adaptyvbio/open-nest/TRADEMARKS.md

# Trademarks

The licenses in this repository cover the design, not the Adaptyv name or logo. Those stay with
Adaptyv.

You may make, use and sell plates from this design under its license. You may keep the engraving
on a plate built from the unmodified reference geometry, with `cad/nest.py` and your own holes.

If you change the pocket, tabs, notches or seat, build with `--no-branding`, so that the part does
not carry a name that vouches for a design it no longer matches. Do not use the Adaptyv name or
logo to suggest that Adaptyv makes, tests or endorses your plate.

"SLAS" refers to the ANSI SLAS microplate standards. Other product names belong to their owners. This project is not affiliated with any instrument maker.
