adaptyvbio/open-nest/design/identity-board.png

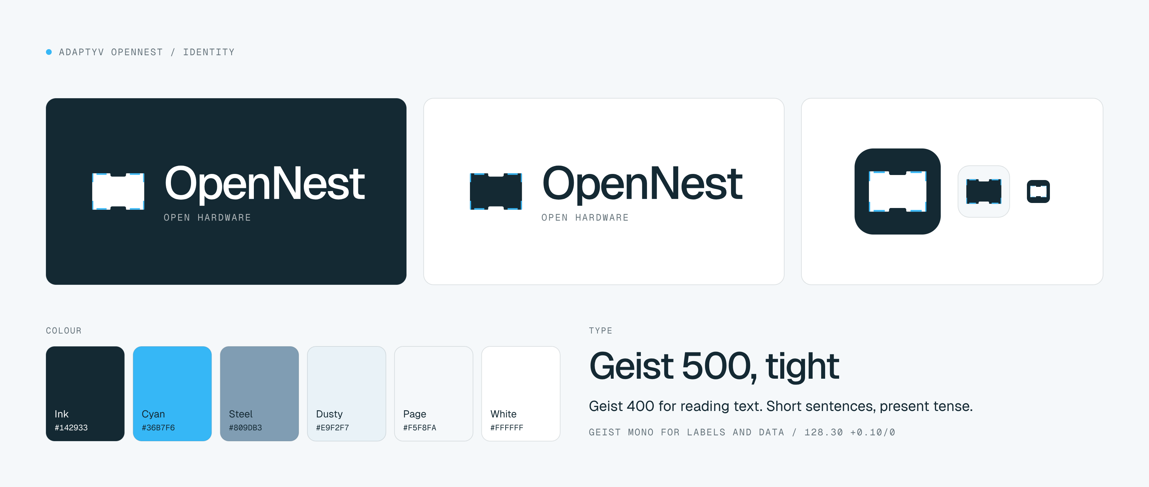
design/identity-board.png
