adaptyvbio/open-nest/docs/img/tab-section.png

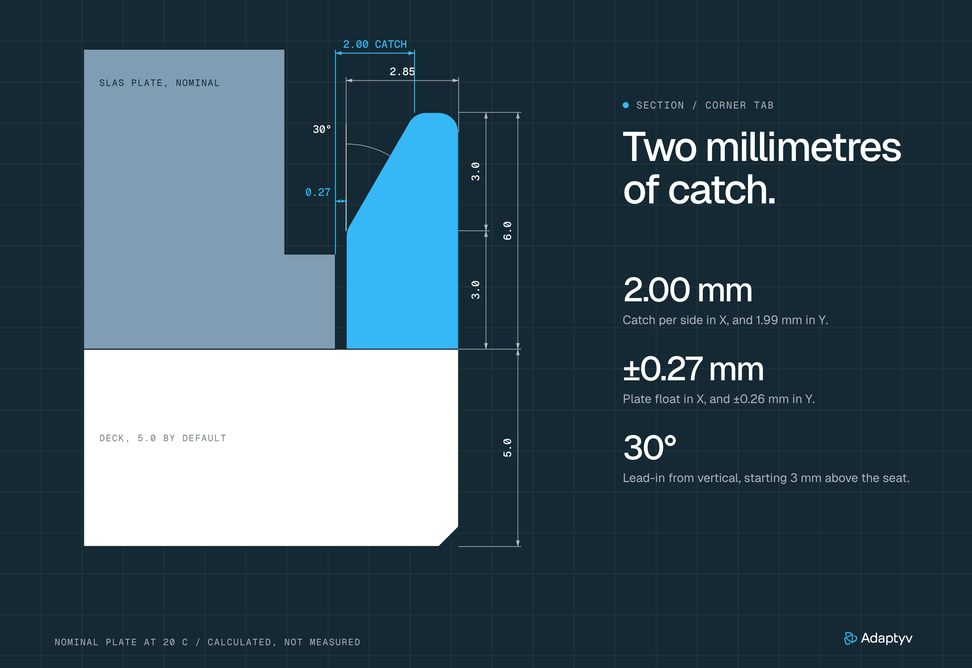
docs/img/tab-section.png
