adaptyvbio/open-nest/models/3d-print/nest.3mf

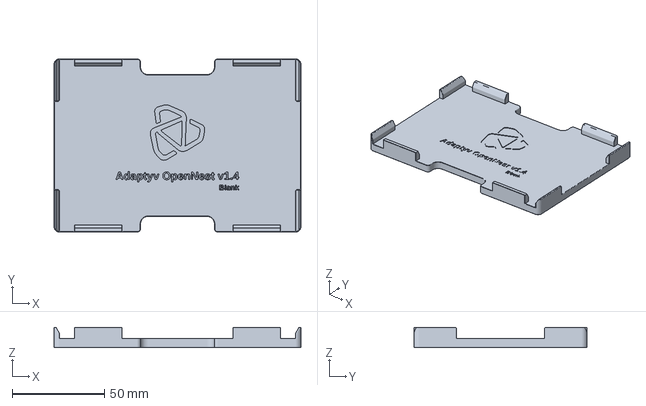
[picture p8: CAD file, 2026-11-04]
models/3d-print/nest.3mf
134.0 x 94.0 x 11.0 mm
