adaptyvbio/open-nest/(list of files, cad)

Other CAD files:
cad/assets/bambu-h2d-template.3mf
models/cnc-aluminium/nest.step
models/cnc-pom-c/nest.step
models/cnc-ptfe/nest.step
models/3d-print/nest.stl
