adaptyvbio/open-nest/docs/OpenNest-Guide.pdf

# OpenNest

# Design and manufacturing

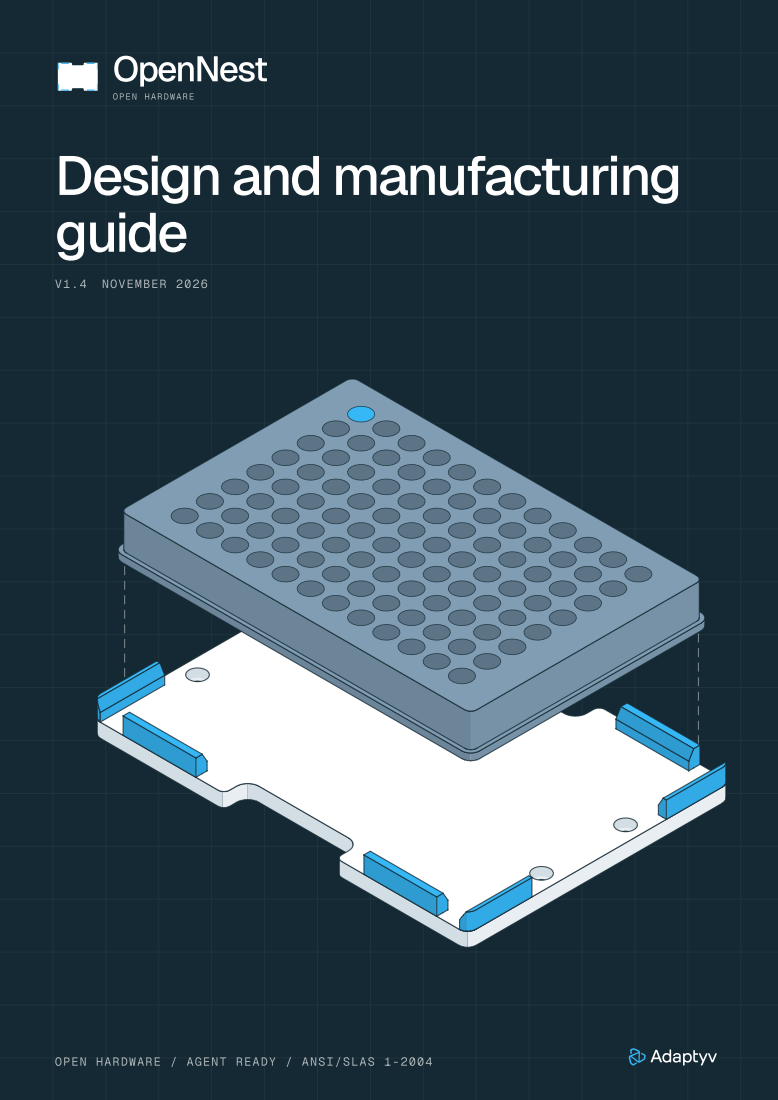
[picture p9: page 1]
OPEN HARDWARE; guide; NOVEMBER 2026; / AGENT READY / ANSI/SLAS 1-2004

Anest for everySLASplate.

### OpenNest is an open hardware deck plate that holds a microplate where a robot can

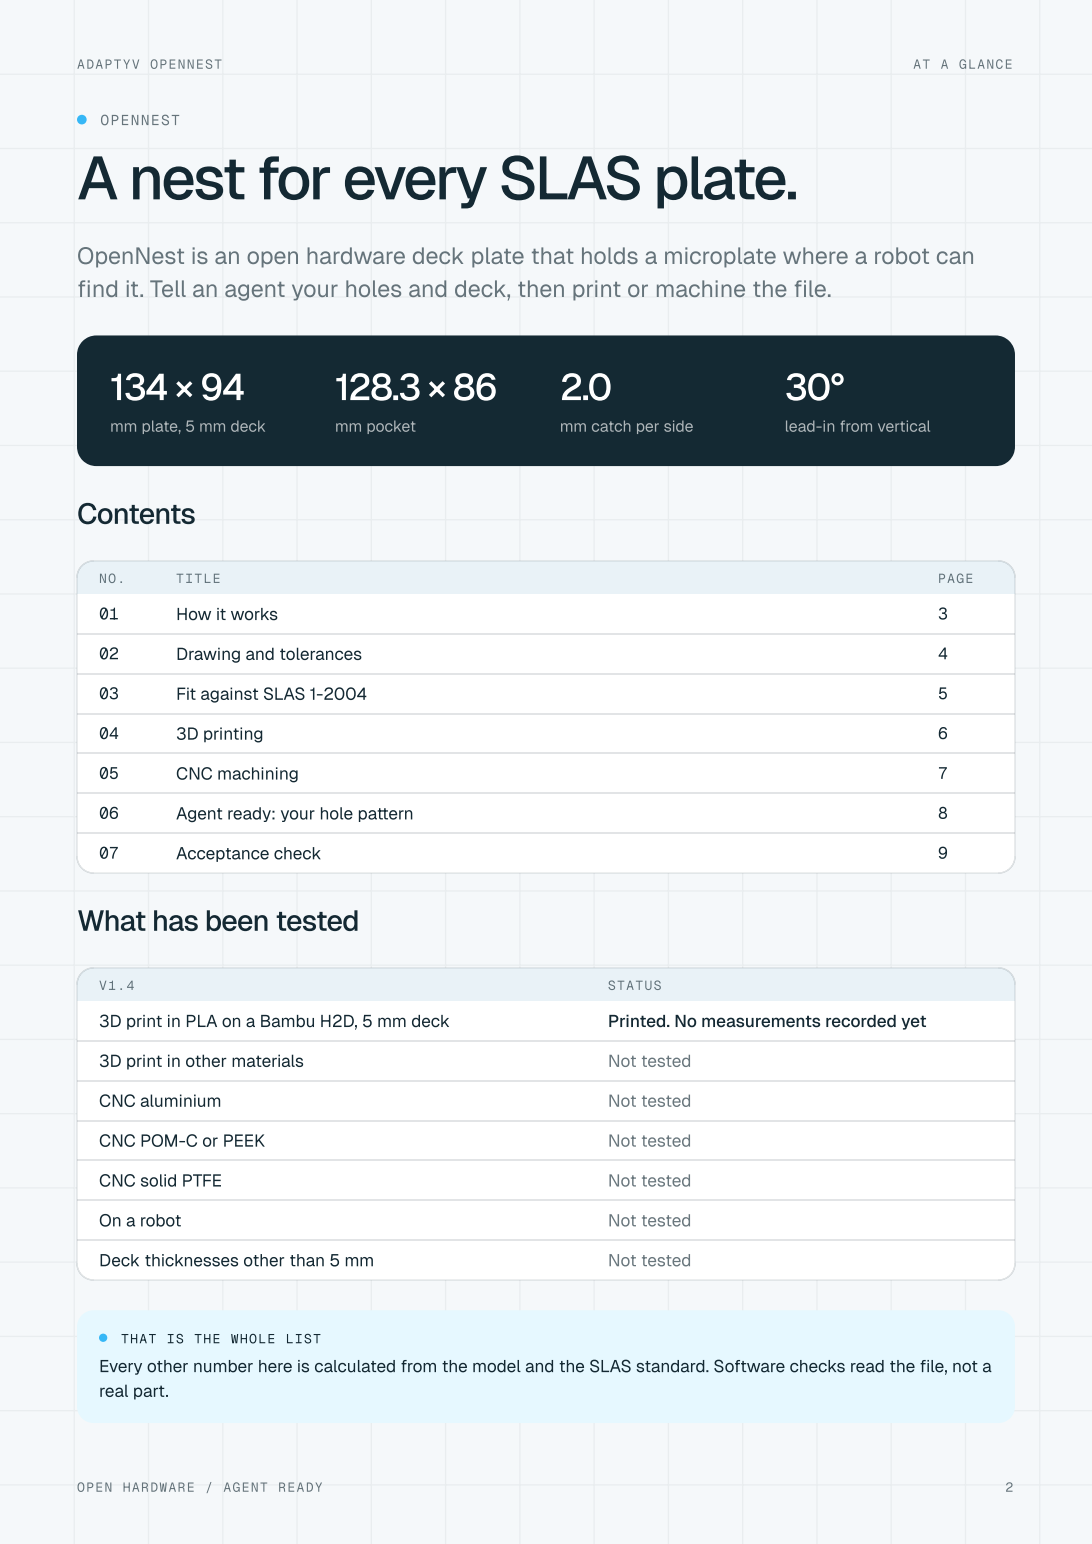
[picture p10: page 2]
ADAPTYV; OPENNEST; AT A GLANCE; find it.; Tell an; agent your holes and deck, then print or machine the file.; mm pocket; Contents; TITLE; PAGE; How it works; Drawing and tolerances; Fit against SLAS 1-2004; 3D printing; CNC machining; Agent; ready: your hole paern; Acceptance check; STATUS; 3D print in PLA; on a Bambu H2D, 5; mm deck; Printed.; No measurements recorded yet; 3D print in other materials; Not tested; CNC aluminium; CNC POM-C or; PEEK; CNC solid PTFE; On a robot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

mm plate, 5 mm deck

mm catch per side

lead-in from vertical

What has been tested

Every surface has a job.

### A robot places a plate with some error. The nest absorbs that error, sets the plate down

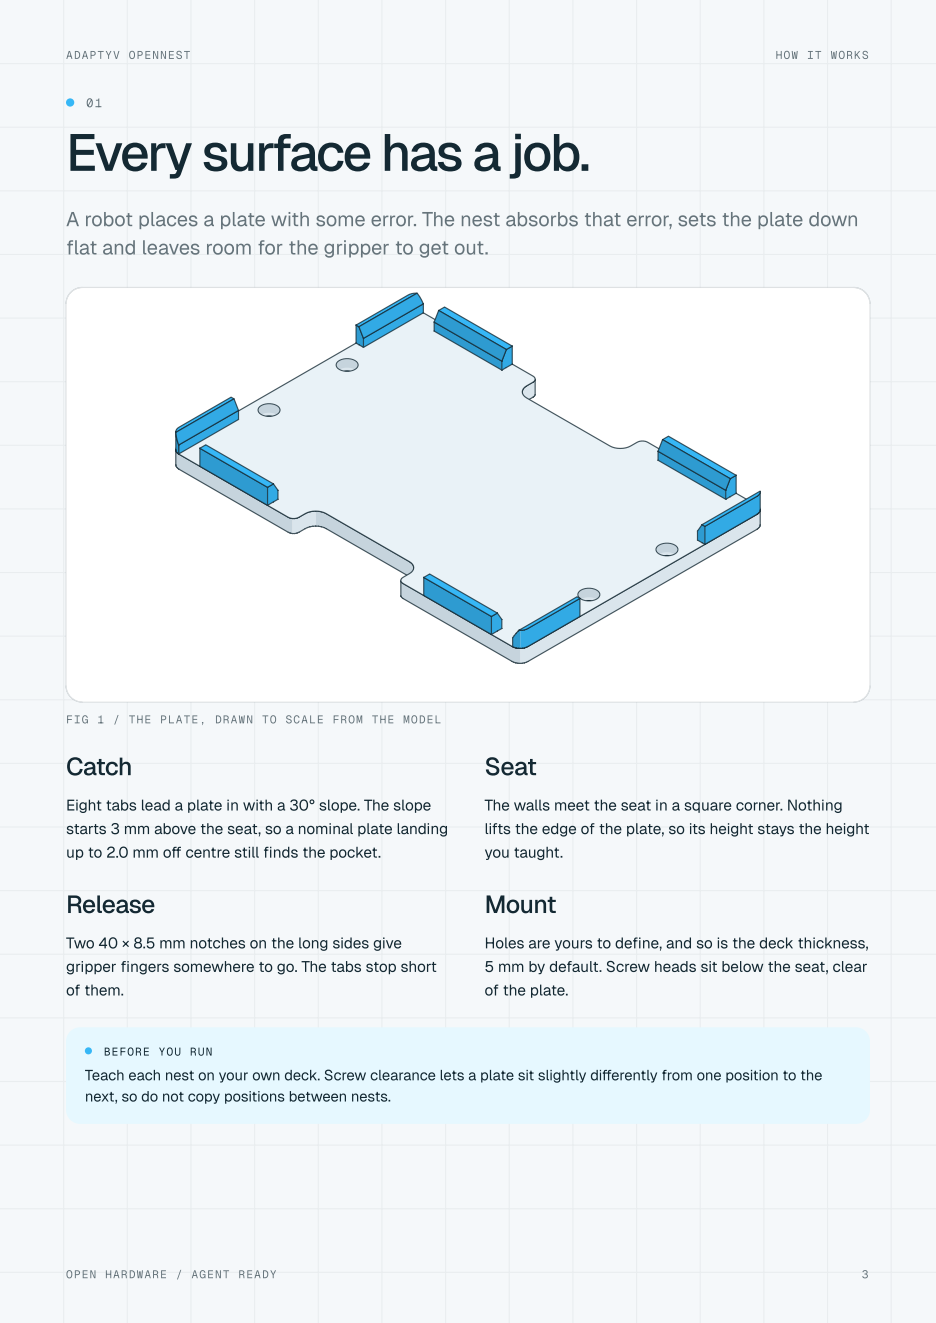
[picture p11: page 3]
ADAPTYV; OPENNEST; HOW IT; WORKS; flat and leaves room; for the; gripper to get out.; FIG 1 /; THE PLATE, DRAWN; TO SCALE FROM THE MODEL; Catch; Eight tabs lead a plate in with a 30°; slope. The slope; mm o centre still finds the pocket.; Seat; The; walls meet the seat in a square corner. Nothing; lifts; the edge of the plate, so its height stays the; height; you; taught.; Release; Two 40 × 8.5 mm; notches on the long sides give; gripper fingers somewhere; to go. The tabs stop short; of them.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

starts 3 mm above the seat, so a nominal plate landing

Holes are yours to define, and so is the deck thickness,

of the plate.

next, so do not copy positions between nests.

Drawing and tolerances.

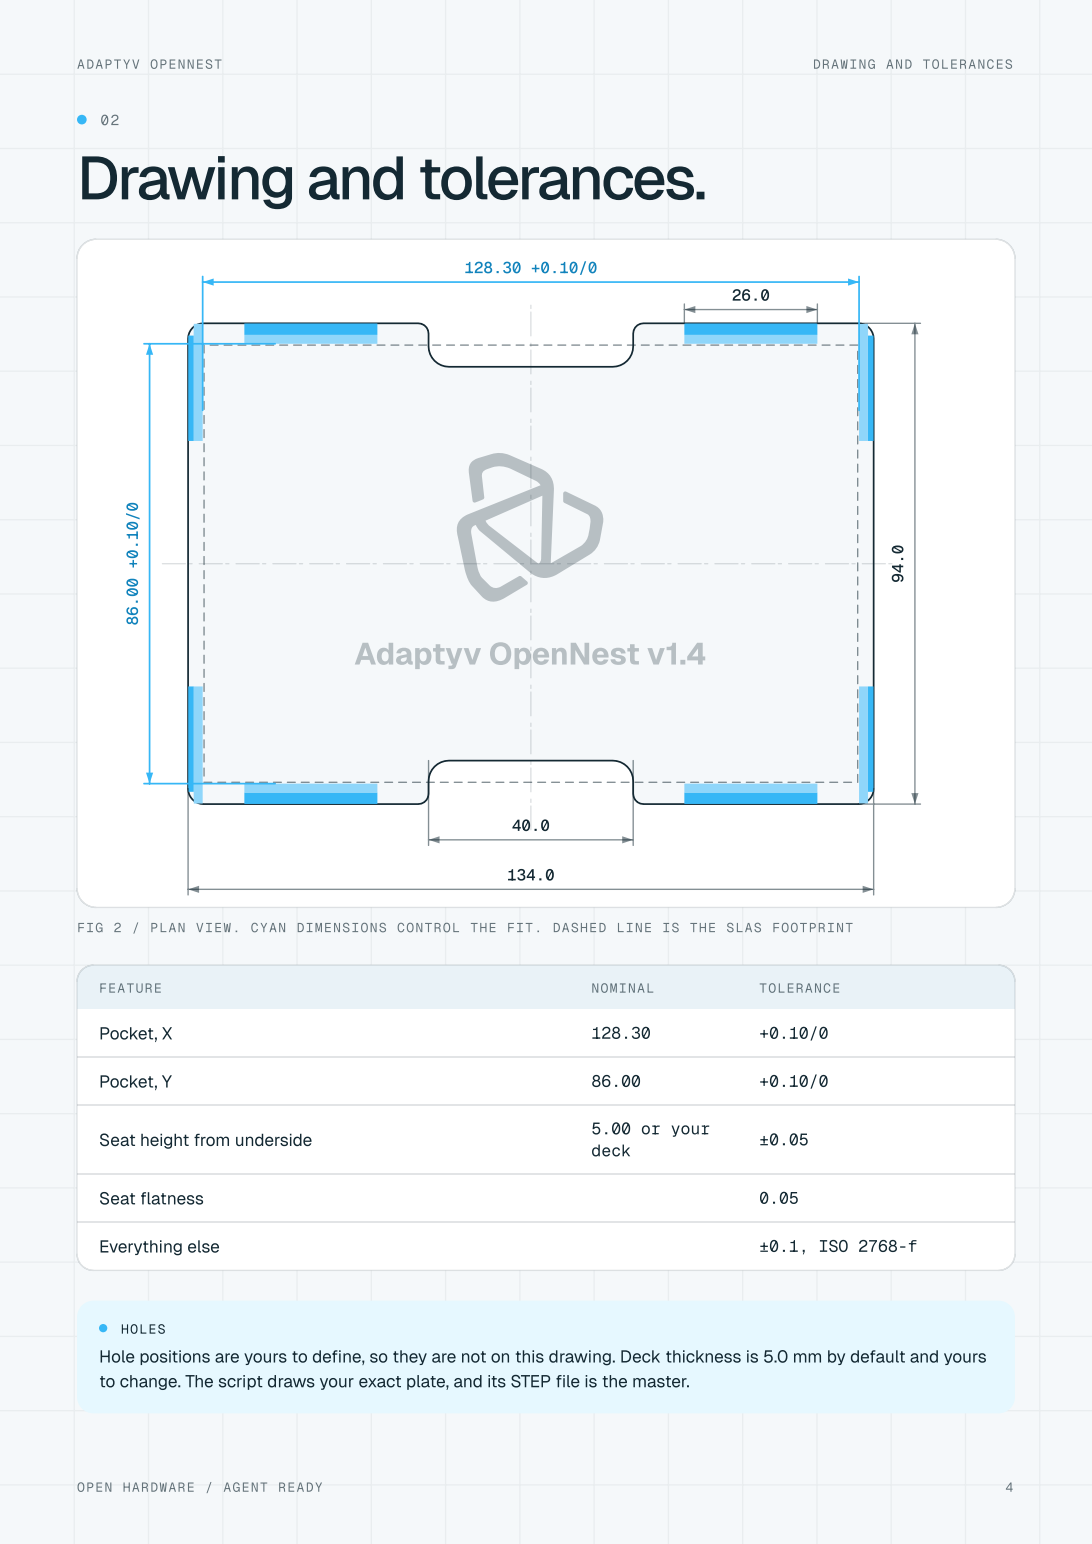
[picture p12: page 4]
ADAPTYV; OPENNEST; DRAWING AND TOLERANCES; Adaptyv OpenNest v1.4; FIG 2 /; PLAN VIEW. CYAN; DIMENSIONS CONTROL THE FIT. DASHED LINE IS THE SLAS FOOTPRINT; FEATURE; NOMINAL; TOLERANCE; Pocket, X; Pocket, Y; your; deck; Seat flatness; Everything else; ISO 2768-f; HOLES; Hole positions are yours to define, so they are not on this drawing. Deck thickness; is 5.0 mm by default and yours

Seat height from underside

to change. The script draws your exact plate, and its STEP file is the master.

Fit againstSLAS1-2004.

By calculation, every plate the standard allows fits at 20 °C. Clearance is total, in mm.

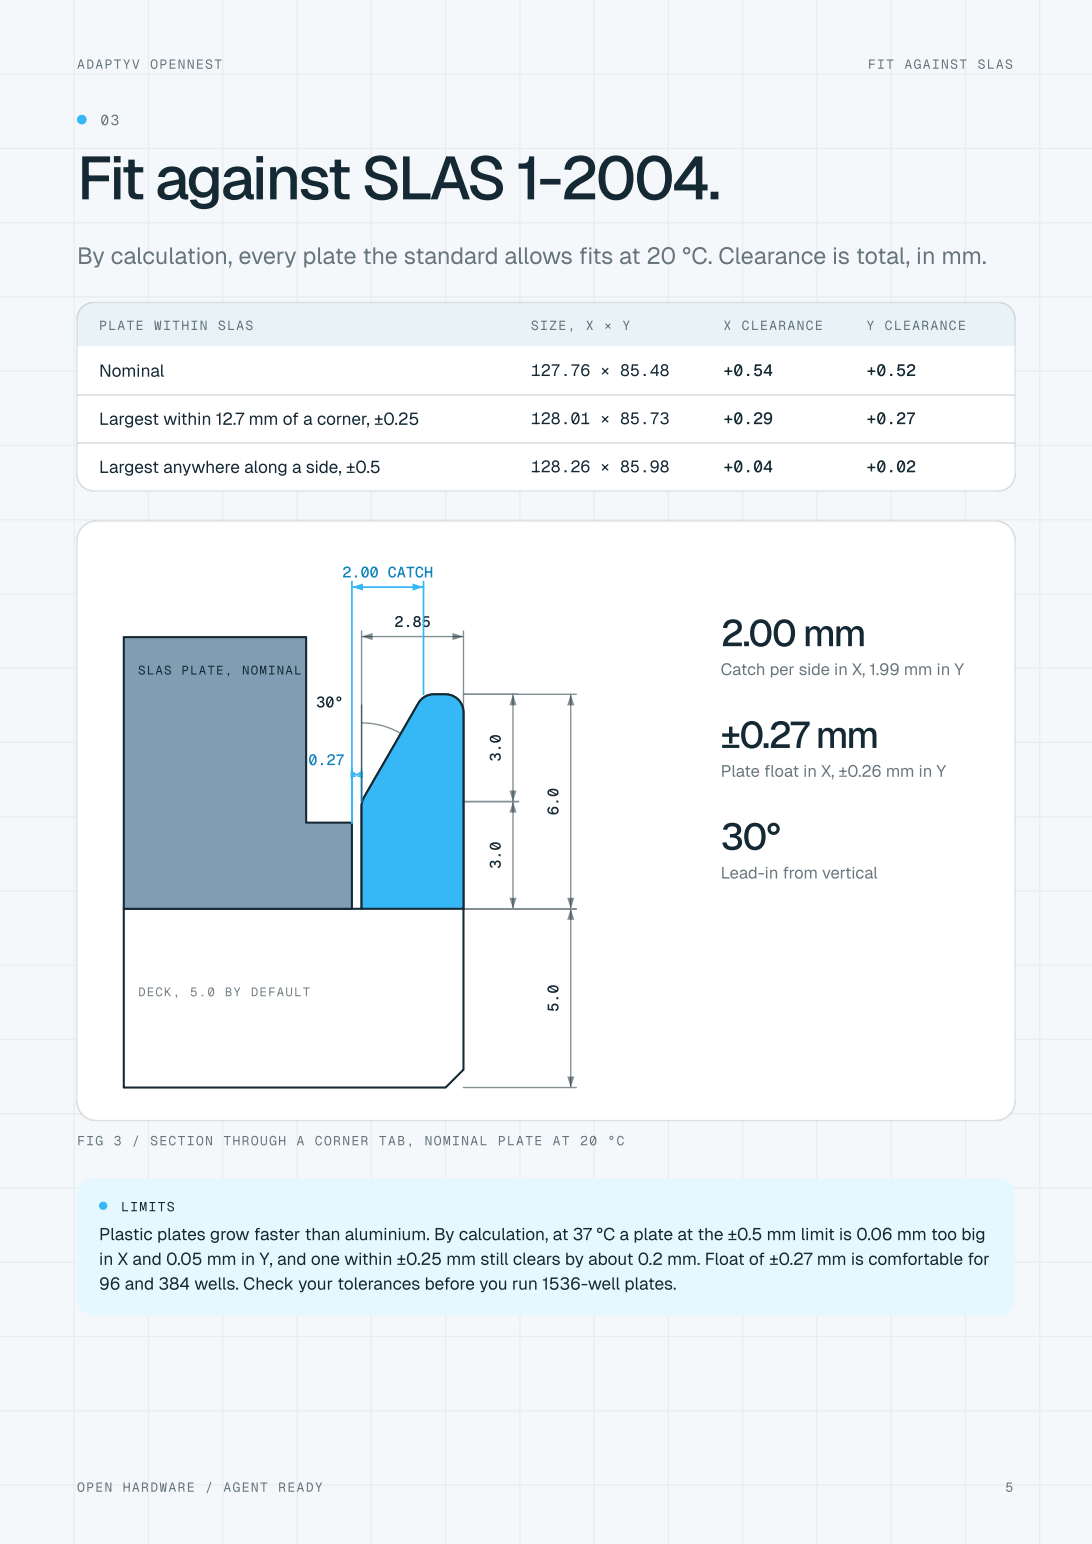
[picture p13: page 5]
ADAPTYV; OPENNEST; FIT AGAINST; SLAS; PLATE; WITHIN SLAS; SIZE, X; CLEARANCE; Y CLEARANCE; Nominal; Largest within 12.7 mm of; a corner, ±0.25; Largest anywhere along a side, ±0.5; 2.00 CATCH; DECK, 5.0; BY DEFAULT; Plate float in; Lead-in from; vertical; FIG 3 /; SECTION; THROUGH; A CORNER; TAB, NOMINAL PLATE AT 20 °C; LIMITS; Plastic plates grow faster than aluminium. By calculation, at 37; °C a plate at the ±0.5 mm limit is 0.06; mm too big; in X and 0.05 mm in Y, and one within ±0.25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

SLAS PLATE, NOMINAL

Catch per side in X, 1.99 mm in Y

3D printing.

A print | proves | the geometry, not the material. Measure it before you trust it.

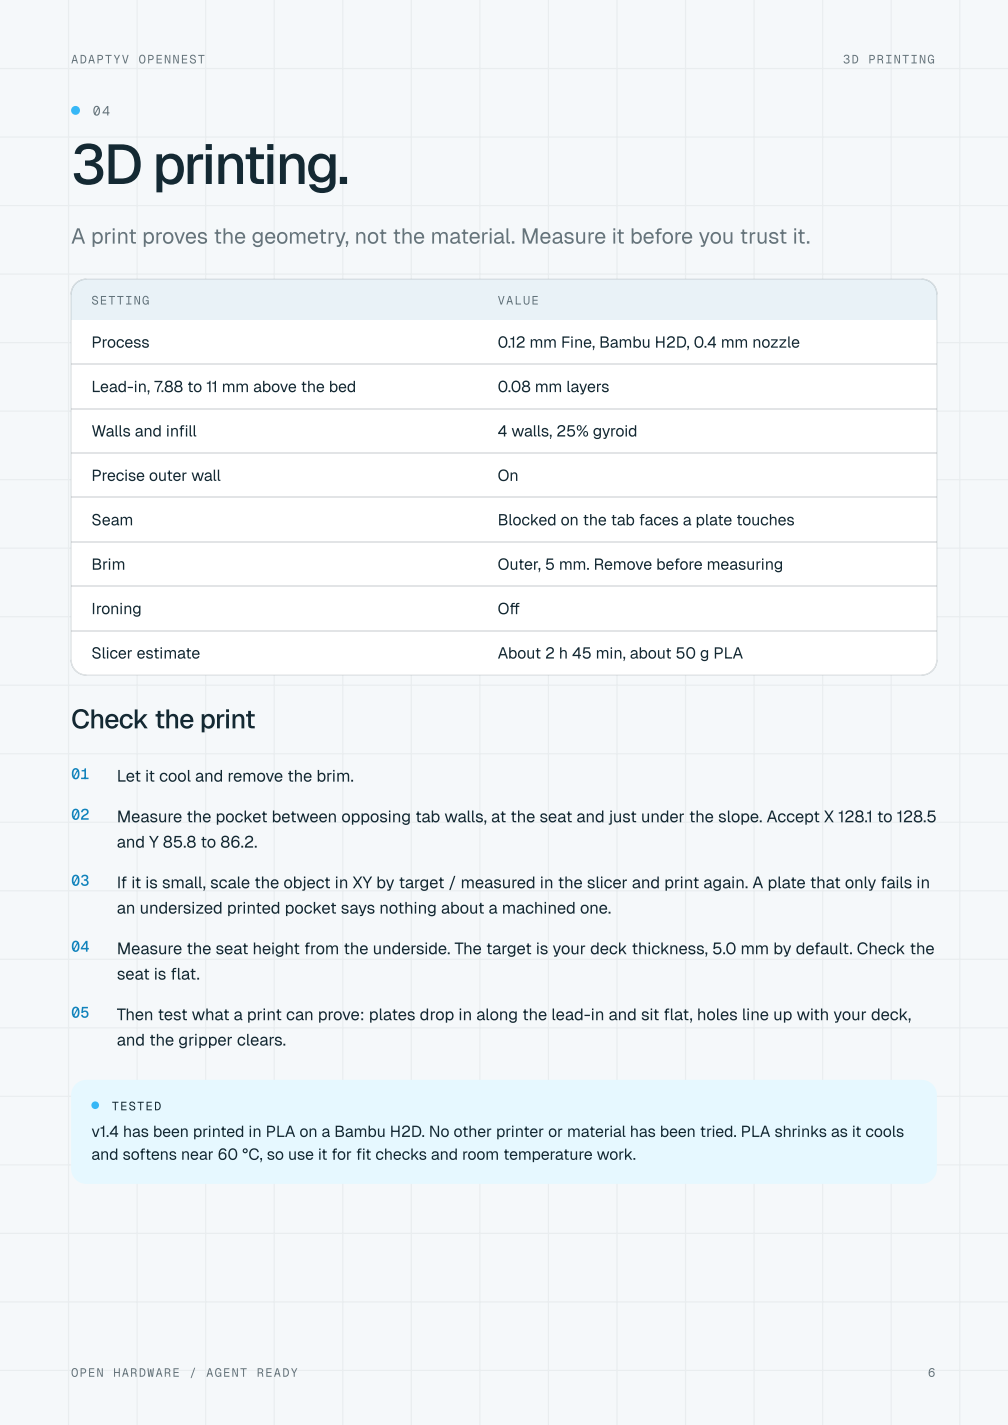
[picture p14: page 6]
ADAPTYV; OPENNEST; 3D PRINTING; SETTING; VALUE; Process; 0.12 mm Fine, Bambu H2D, 0.4 mm; nozzle; Lead-in, 7.88 to; 11 mm above the bed; 0.08 mm layers; Walls and infill; 4 walls, 25% gyroid; Precise outer wall; Seam; Blocked on the tab faces; a plate touches; Brim; Outer, 5 mm. Remove before measuring; Ironing; Slicer; estimate; About 2 h 45 min, about 50 g PLA; Let it cool and remove the brim.; Measure the pocket between; opposing tab walls, at the seat and just under; the slope. Accept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

Check the print

seat is flat.

and the gripper clears.

and softens near 60 °C, so use it for fit checks and room temperature work.

CNC machining.

The STEP file is the part. A machine cuts it as drawn, with no shrink correction. No plate

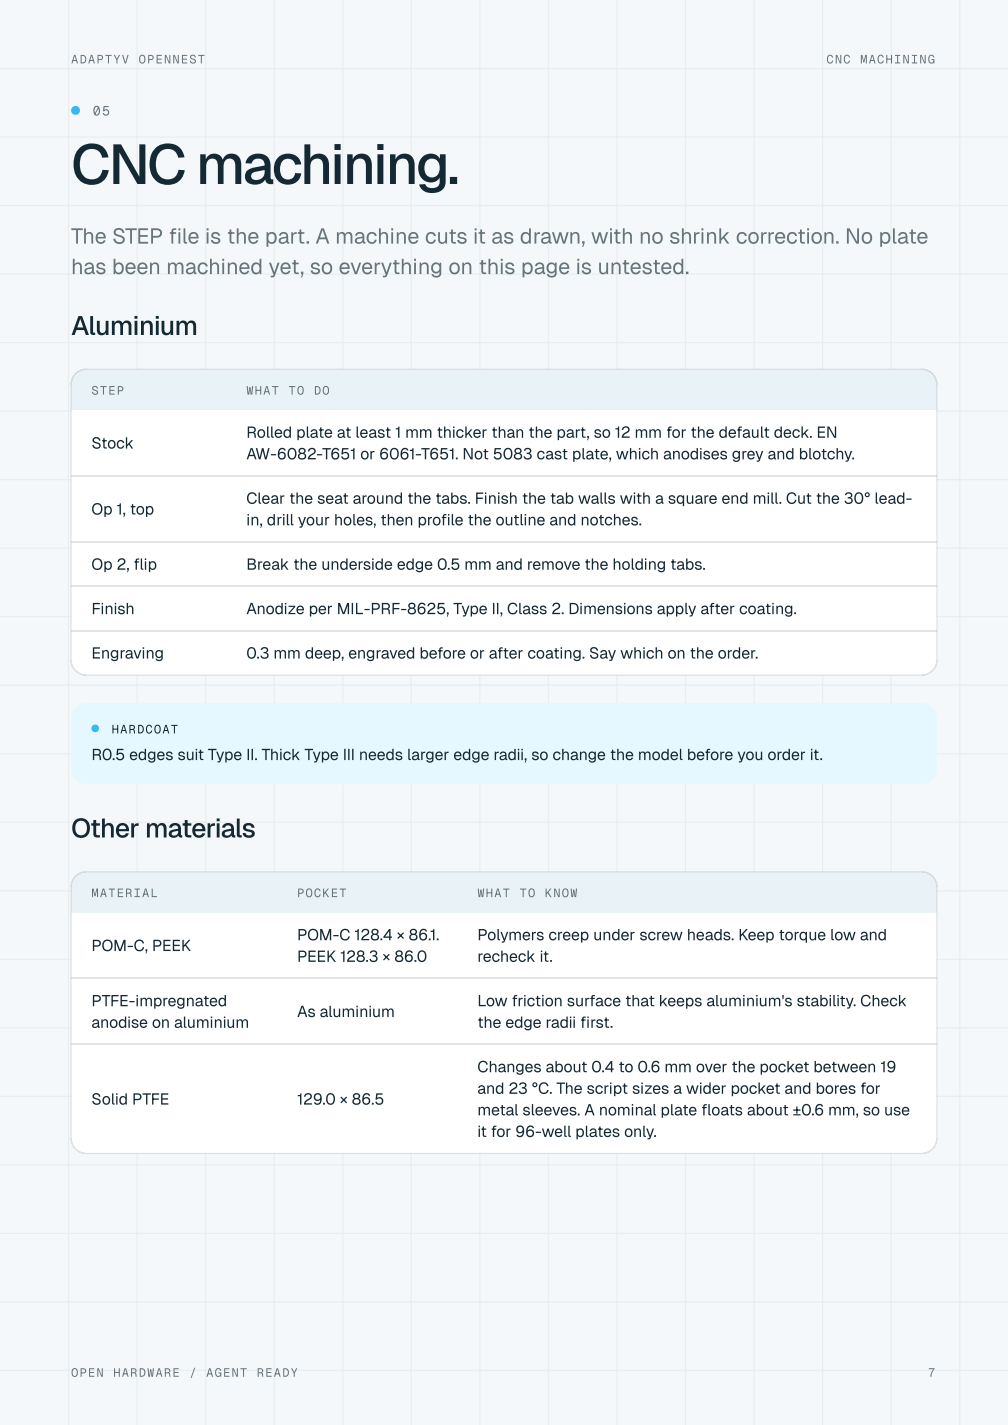
[picture p15: page 7]
ADAPTYV; OPENNEST; CNC MACHINING; has been machined yet, so everything on; this page is untested.; Aluminium; STEP; WHAT TO DO; Stock; Rolled plate at least 1 mm thicker than the part, so; 12 mm for; the default deck. EN; Op 1, top; Clear the seat around the tabs. Finish the; tab walls; with a square end; mill. Cut the 30° lead-; in, drill your holes, then profile the outline; and notches.; Op 2, flip; Break the underside edge 0.5 mm and remove the holding tabs.; Finish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

AW-6082-T651 or 6061-T651. Not 5083 cast plate, which anodises grey and blotchy.

PTFE-impregnated
anodise on aluminium

Low friction surface that keeps aluminium's stability. Check

the edge radii first.

it for 96-well plates only.

Agent ready.

### The pocket, tabs and notches stay fixed. An LLM agent reads the spec, runs the script

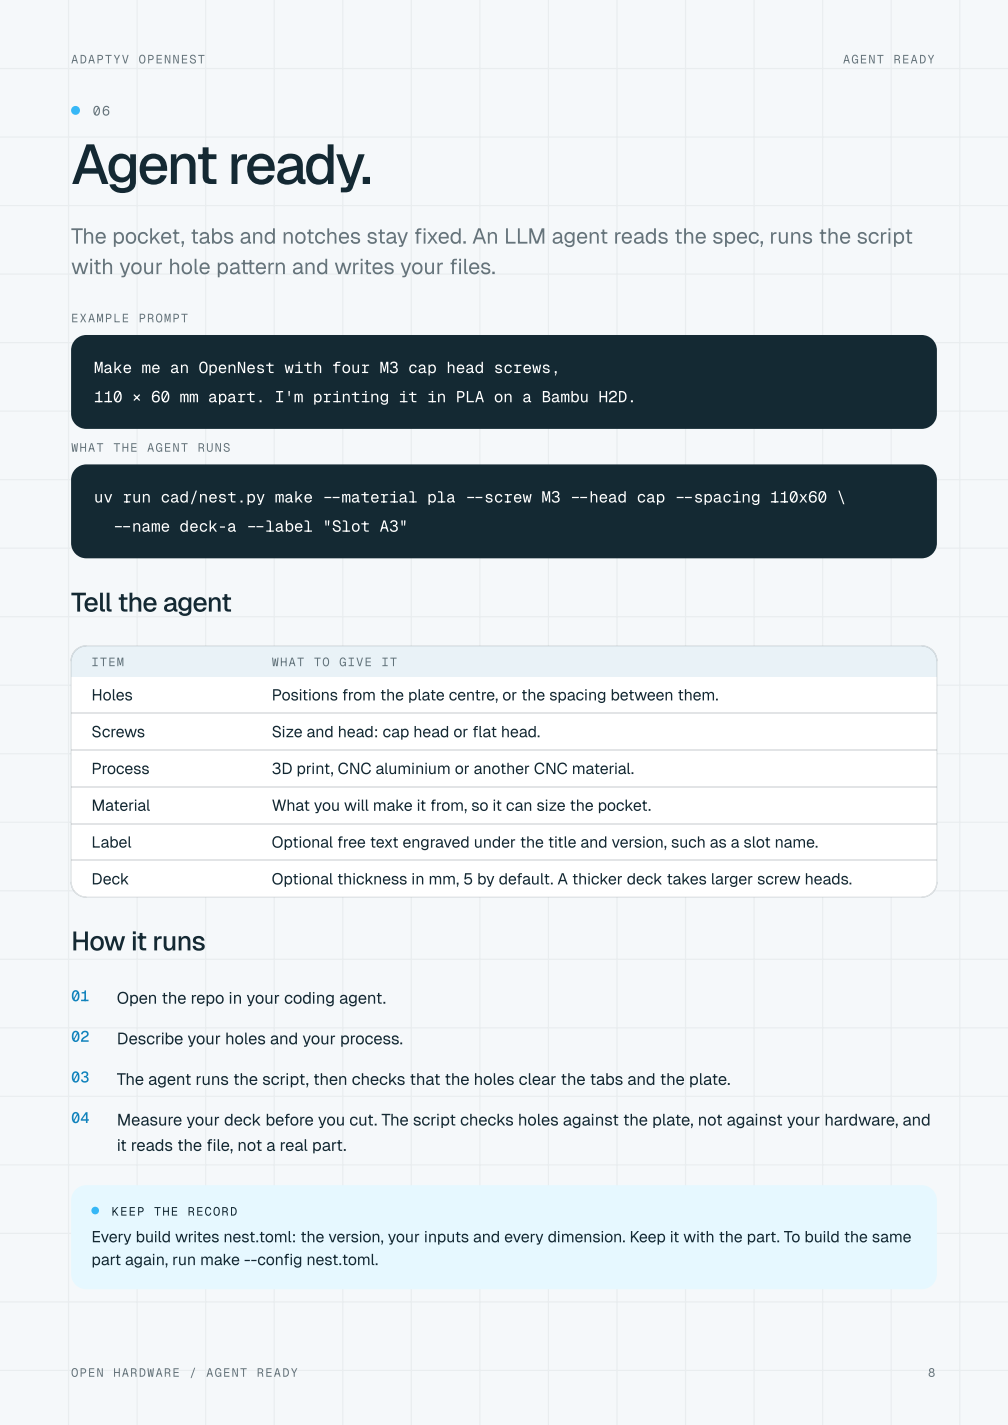
[picture p16: page 8]
ADAPTYV; OPENNEST; AGENT; READY; EXAMPLE; PROMPT; Make; me an OpenNest; with four M3 cap head screws,; apart.; I'm printing it in PLA on a Bambu H2D.; WHAT THE; AGENT RUNS; uv run cad/nest.py; make material pla screw M3 head cap spacing 110x60 \; ITEM; WHAT TO GIVE IT; Holes; Positions from the plate centre, or the; spacing between them.; Screws; Size and head: cap head or flat head.; Process; 3D print, CNC aluminium or another CNC material.; Material; What you will make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

with your hole paern and writes your files.

name deck-a label "Slot A3"

Tell the agent

How it runs

KEEP THE RECORD
Every build writes nest.toml: the version, your inputs and every dimension. Keep it with the part. To build the same
part again, run make --config nest.toml.

Acceptance check.

Fill this in for each part before it goes on a deck.

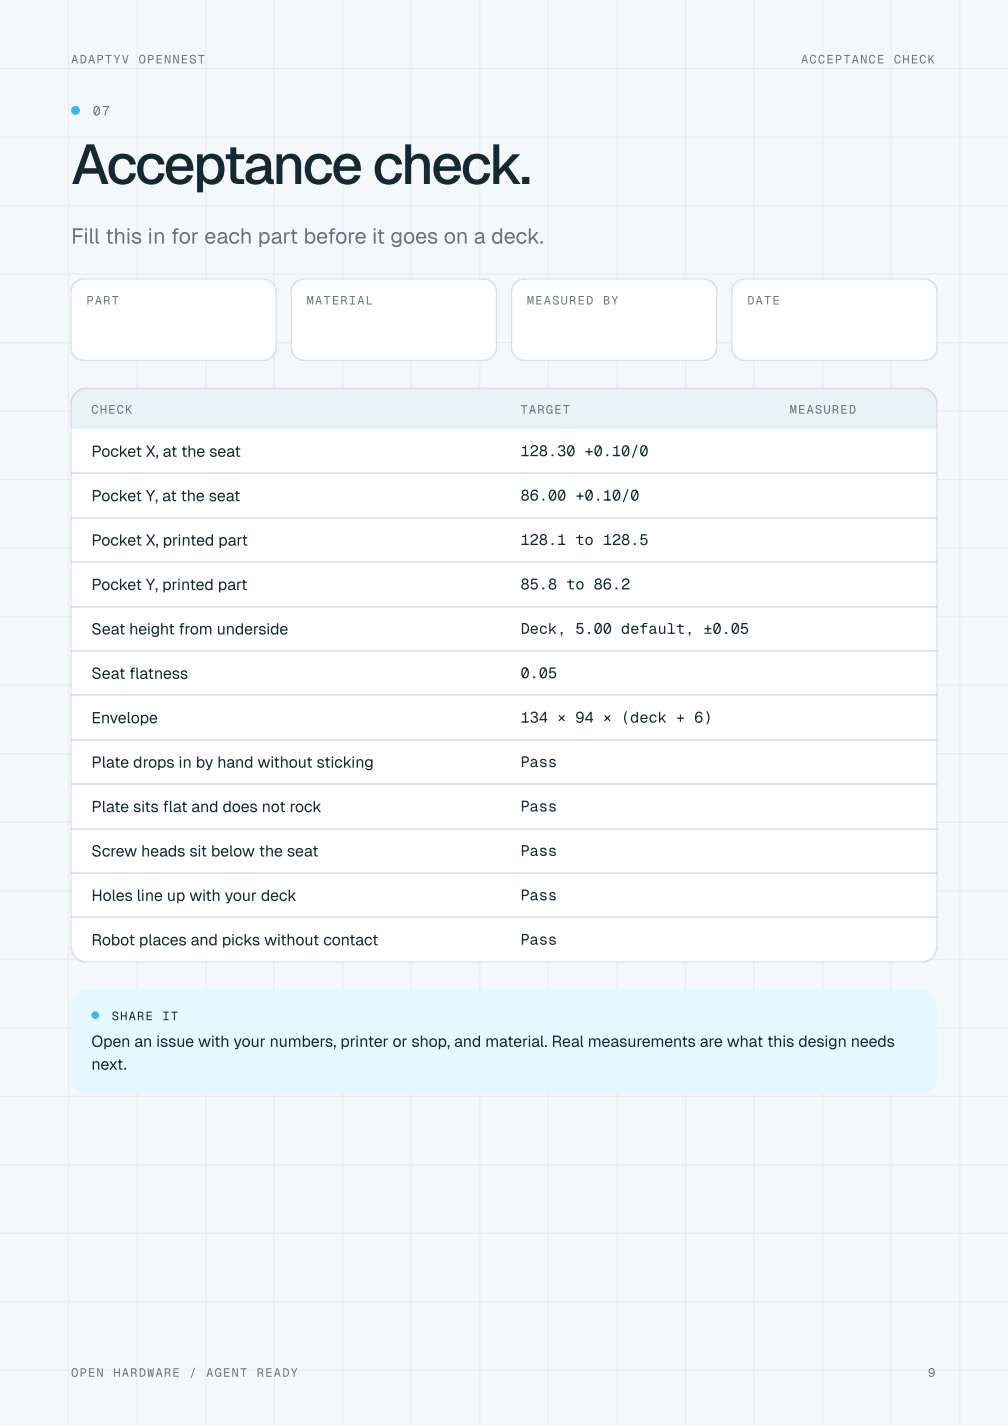
[picture p17: page 9]
ADAPTYV; OPENNEST; ACCEPTANCE; CHECK; PART; MATERIAL; MEASURED BY; DATE; TARGET; MEASURED; Pocket X, at the; seat; Pocket Y, at the; Pocket X, printed part; Pocket Y, printed part; Seat height from underside; Deck, 5.00; default, ±0.05; Seat flatness; Envelope; (deck +; Plate drops in by hand without sticking; Pass; Plate sits flat and does not rock; Screw heads sit below the seat; Holes line up with your deck; Robot places and picks without contact; SHARE IT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

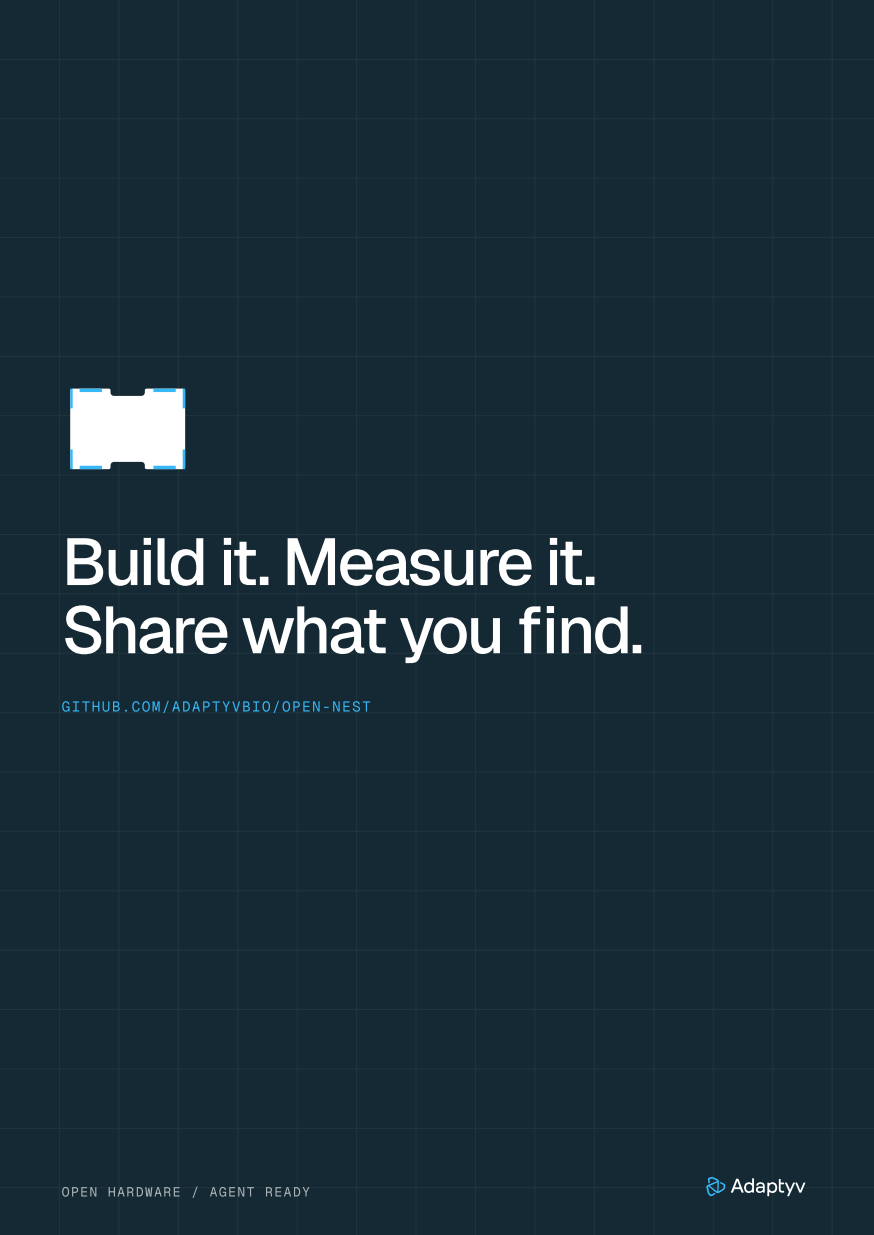
[picture p18: page 10]
OPEN HARDWARE; / AGENT READY

Build it. Measure it.
Share what youfind.

GITHUB.COM/ADAPTYVBIO/OPEN-NEST
