adaptyvbio/open-nest/models/cnc-aluminium/drawing.pdf

# OpenNest deck plate

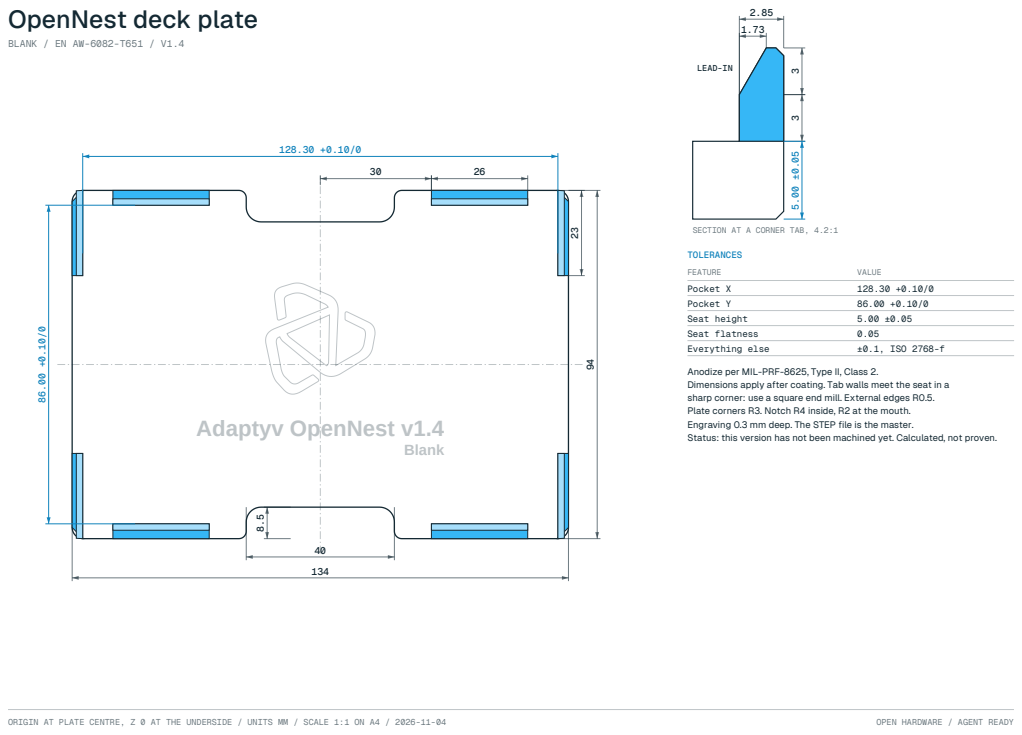
[picture p19: page 1]
Adaptyv OpenNest v1.4; Blank; LEAD-IN; TOLERANCES; FEATURE; VALUE; Pocket X; Pocket Y; Seat height; Seat flatness; Everything else; ±0.1, ISO 2768-f; ORIGIN AT PLATE CENTRE, Z 0 AT THE UNDERSIDE / UNITS MM / SCALE 1:1 ON A4 / 2026-11-04; OPEN HARDWARE / AGENT READY

BLANK / EN AW-6082-T651 / V1.4

SECTION AT A CORNER TAB, 4.2:1

Anodize per MIL-PRF-8625, Type II, Class 2.
Dimensions apply after coating. Tab walls meet the seat in a
sharp corner: use a square end mill. External edges R0.5.
Plate corners R3. Notch R4 inside, R2 at the mouth.
Engraving 0.3 mm deep. The STEP file is the master.
Status: this version has not been machined yet. Calculated, not proven.
