adaptyvbio/open-nest/(commit log)

2026-11-04 Add OpenNest design assets, guide and work-in-progress CAD
    Identity, README figures and the Pencil design source, the design and
    manufacturing guide, licenses, and the plan and geometry modules for the
    agent-run build script. The script and release models are not finished.
2026-11-04 Add the agent-run build script, release models and repo docs
    cad/nest.py checks a hole pattern, builds the plate, reads the STEP back to
    verify it, and writes a shop drawing or Bambu project. Each build also writes
    nest.toml, a design record that holds the version, commit, inputs and every
    dimension, and --config rebuilds the part from it. --label engraves free text
    under the title and version. The pocket is sized by material.
    The geometry matches the earlier v1.4 plates, apart from the flat head
    countersink, which is now a true 90 degrees.
    Also adds AGENTS.md, reference plates in models/, per-version dimensions in
    docs/versions/, tests, CI, licenses, a trademark policy, an OKH manifest an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
    [bambu-h2d-template.3mf, nest.3mf, nest.step, nest.stl]
2026-11-04 Return clean errors from the CLI for bad labels and records
    An unsupported label character or an unreadable --config crashed with a
    traceback. They now print an error and exit 2, like every request that cannot
    be built, and bad flags exit 2 instead of 1.
2026-11-04 State exactly what has been tested, and finish the guide and figures
    The only real test of v1.4 is a plate printed in PLA on a Bambu H2D. The
    README, guide, figures, CLI, design record and shop drawings now all say so.
    The guide gains a test status table, a note on warm plates, the corrected PTFE
    text, the real command, --label and nest.toml. The figures list the real output
    files and show test status per process.
    [nest.3mf, nest.step]
2026-11-04 Make deck thickness a setting and ready the repo to go public
    --deck sets the deck thickness from 2 to 30 mm, with 5 mm as the default. The
    seat, the height, the drawing, the design record and the Bambu layer ranges all
    follow it. Screw heads are limited by the floor they leave, so a thick enough
    deck takes M4 to M6 cap heads. PTFE sleeve length follows the deck too.
    The default 5 mm plate is unchanged. The guide and figures cover the setting,
    and only the 5 mm deck is marked as printed.
    Removes the note that the repo is internal and a work in progress, so the
    visibility can simply be flipped.
    [nest.3mf, nest.step]
2026-11-04 Publish a GitHub release for every new version
    When a new VERSION reaches main and the tests pass, CI tags the commit
    and publishes the reference plates, the guide and the fixed dimensions.
    The notes come from the changelog, the test table and each plate's report.
    The fast tests now fail if a bump leaves anything on the old version, or
    if the plates in models/ no longer match the code.
